grodansparadis/can4vscp_odessa/docs/remotevar.md

No remote variables currently defined for this module.

[filename](./bottom-copyright.md ':include')
