grodansparadis/can4vscp_odessa/docs/_coverpage.md

VSCP logo

# Manual for the Odessa module

Scroll down to view docs.

[Homepage](https://www.vscp.org)
[Docs](https://www.vscp.org/#documentation)
[Downloads](https://www.vscp.org/#download)
[Get Started](./README)
