grodansparadis/can4vscp_odessa/docs/images/odessa1.png

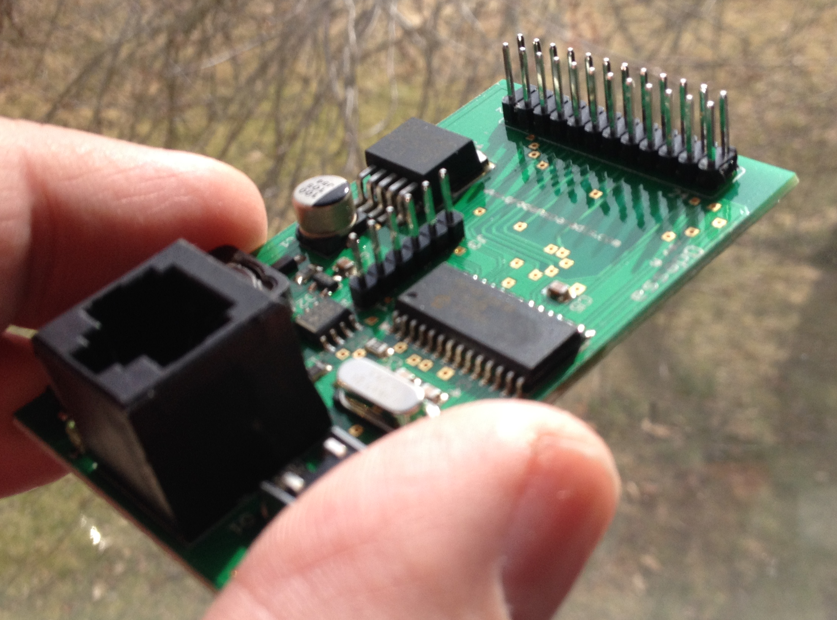
docs/images/odessa1.png
