grodansparadis/can4vscp_odessa/docs/images/odessa2.png

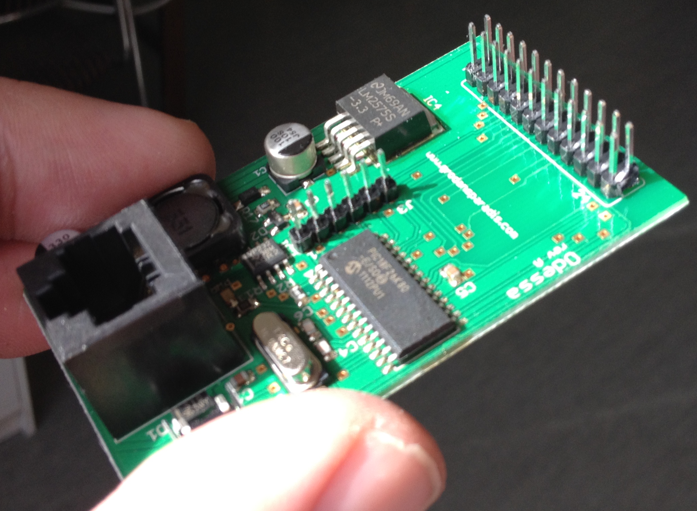
docs/images/odessa2.png
