grodansparadis/can4vscp_odessa/docs/images/odessa3.png

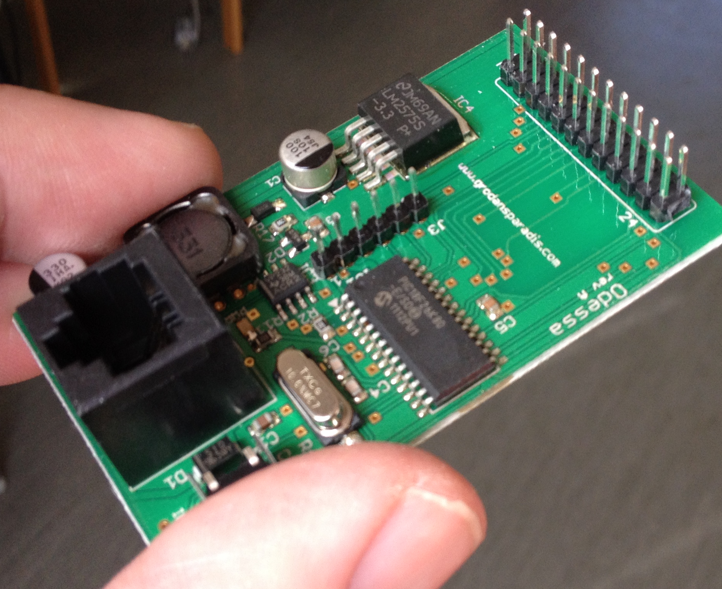
docs/images/odessa3.png
