grodansparadis/can4vscp_odessa/docs/images/odessa4.png

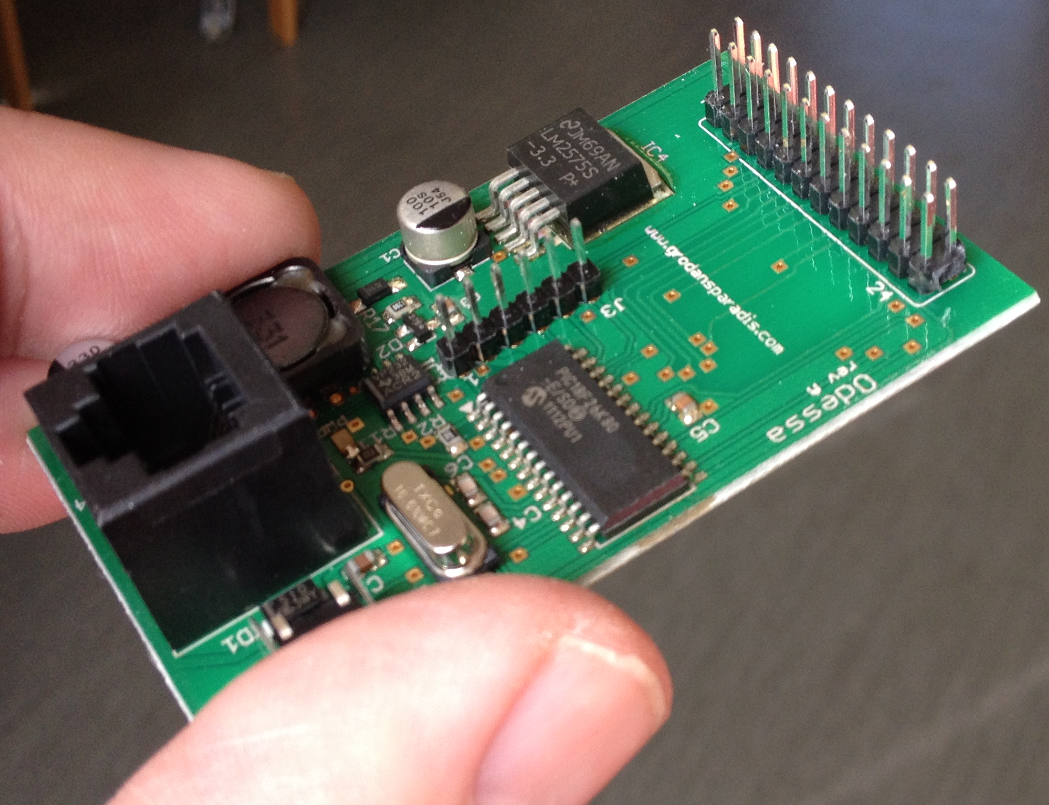
docs/images/odessa4.png
