grodansparadis/can4vscp_odessa/docs/images/odessa5.png

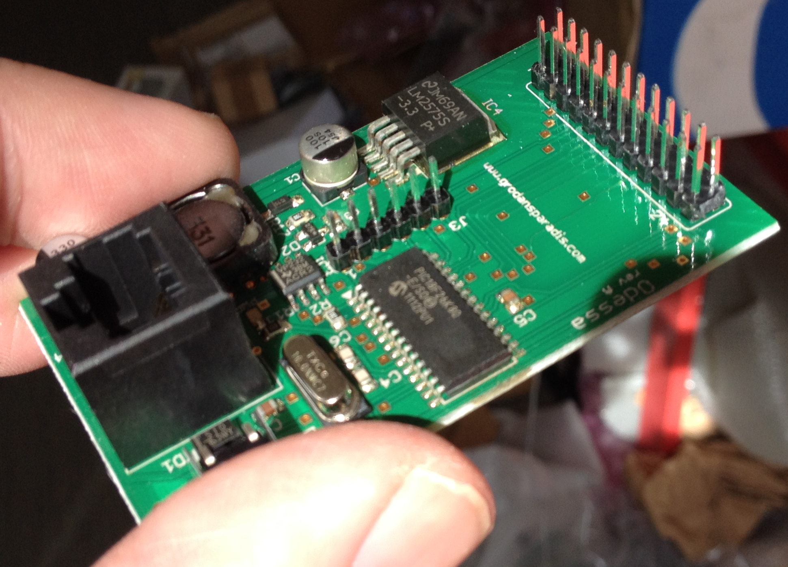
docs/images/odessa5.png
