grodansparadis/can4vscp_odessa/docs/images/odessa7.png

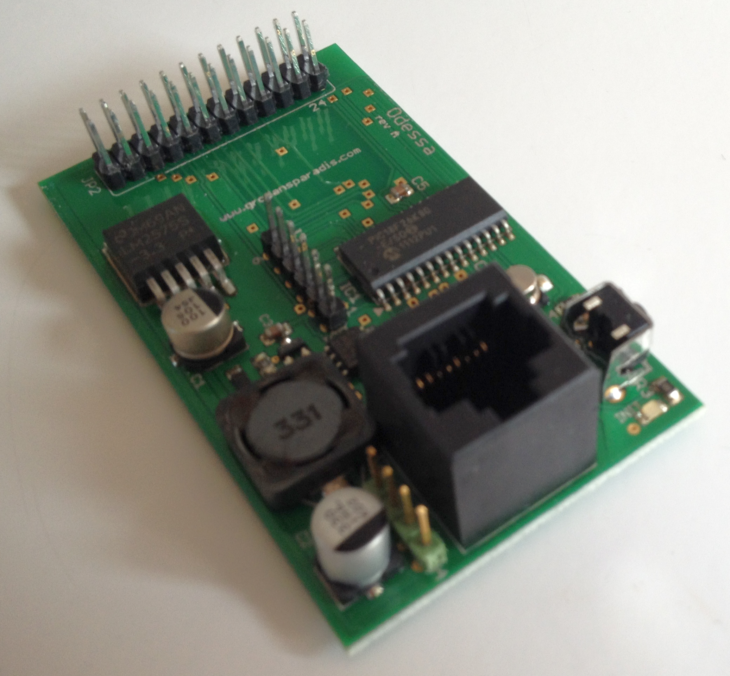
docs/images/odessa7.png
