grodansparadis/can4vscp_odessa/docs/images/odessa8.png

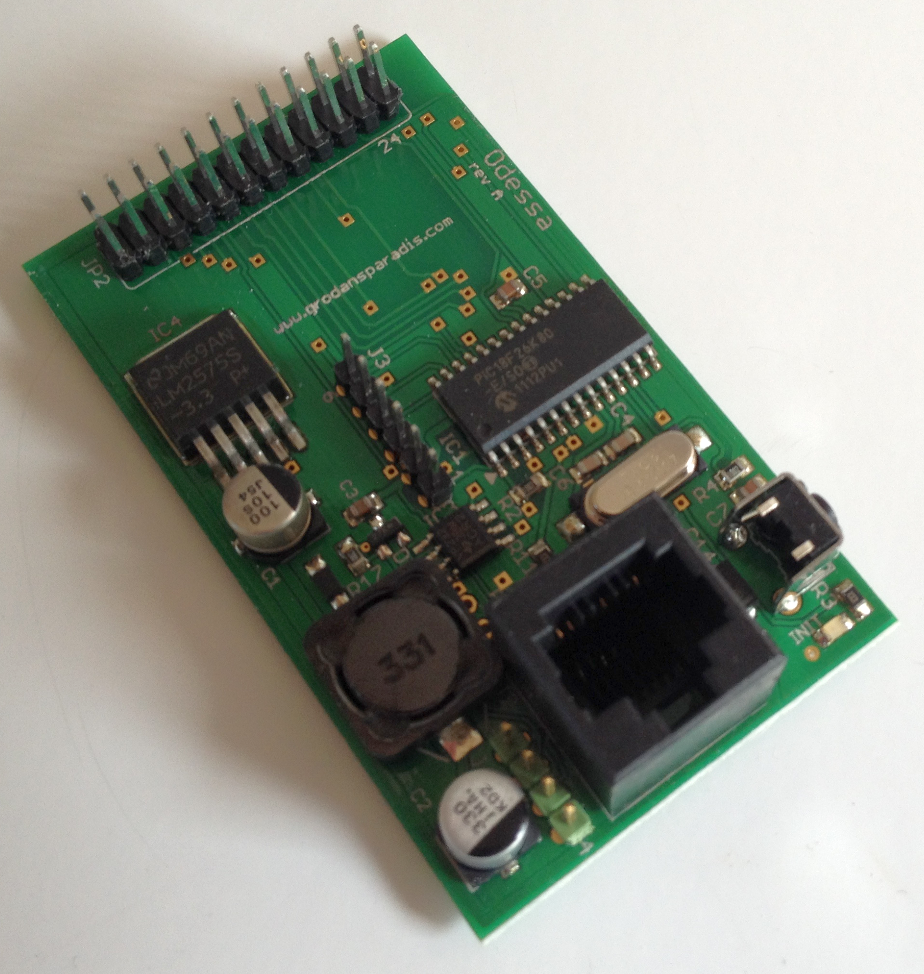
docs/images/odessa8.png
