grodansparadis/can4vscp_odessa/docs/images/odessa9.png

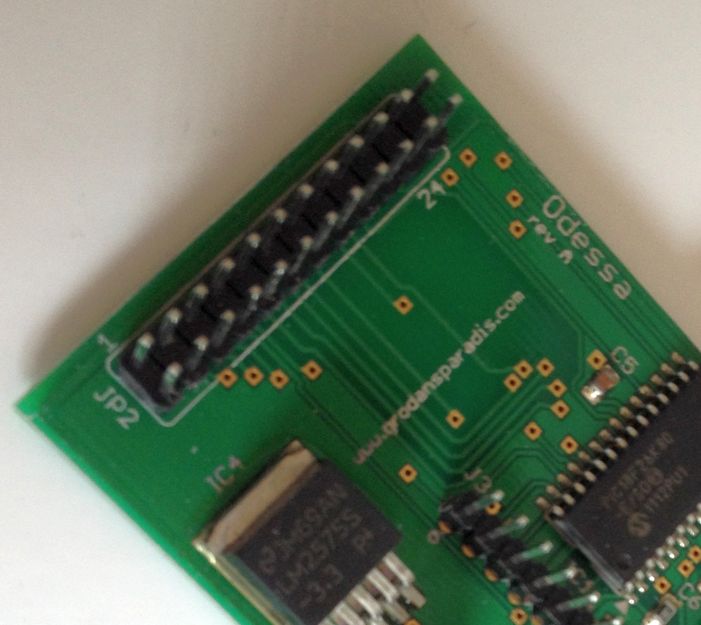
docs/images/odessa9.png
