grodansparadis/can4vscp_odessa/docs/images/odessa10.png

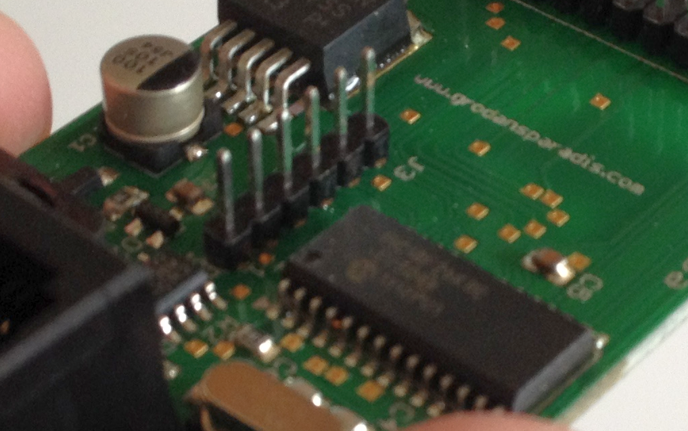
docs/images/odessa10.png
