grodansparadis/can4vscp_odessa/docs/images/odessa11.png

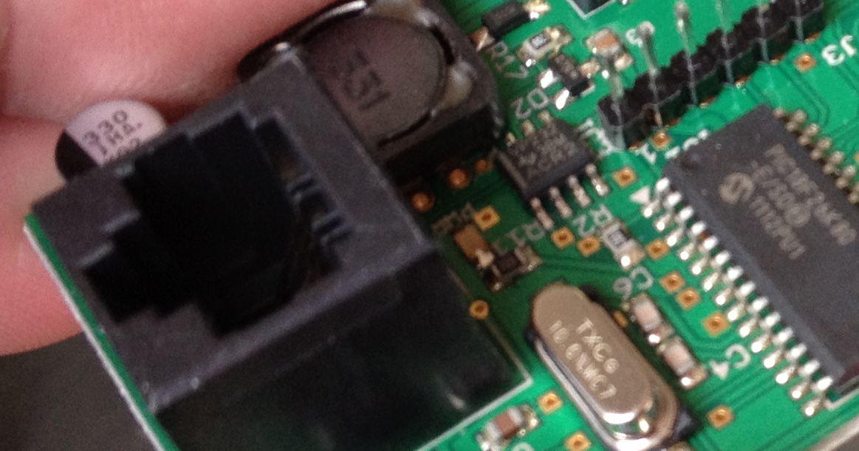
docs/images/odessa11.png
