grodansparadis/can4vscp_odessa/docs/images/odessa12.png

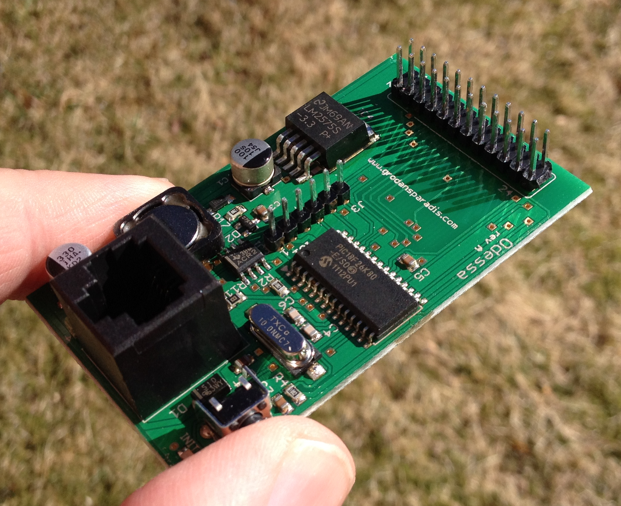
docs/images/odessa12.png
