grodansparadis/can4vscp_odessa/docs/images/odessa13.png

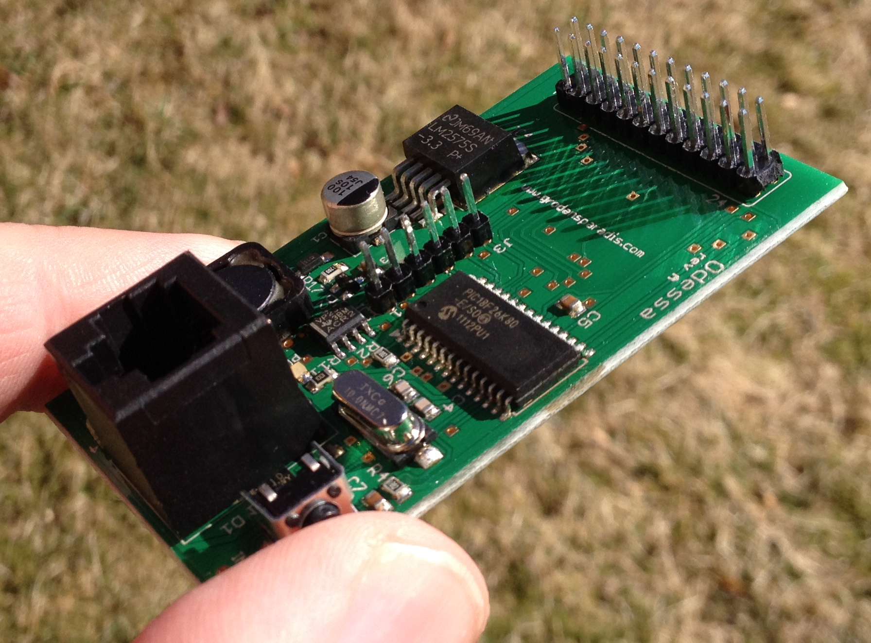
docs/images/odessa13.png
