grodansparadis/can4vscp_odessa/docs/images/odessa15.png

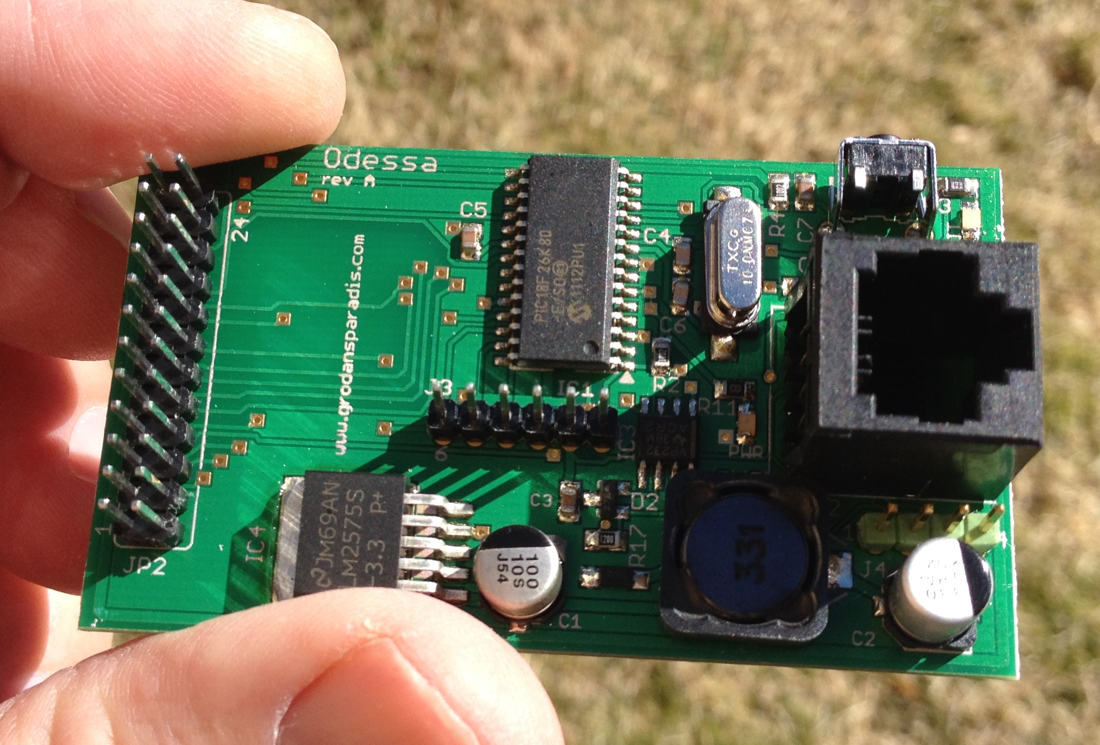
docs/images/odessa15.png
