grodansparadis/can4vscp_odessa/docs/images/odessa16.png

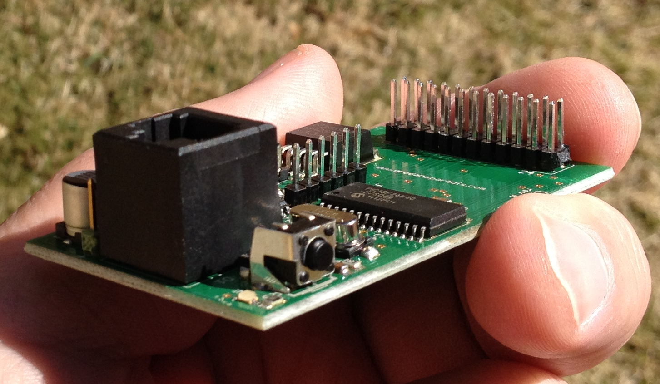
docs/images/odessa16.png
