grodansparadis/can4vscp_odessa/docs/images/odessa_brd_rev_a.png

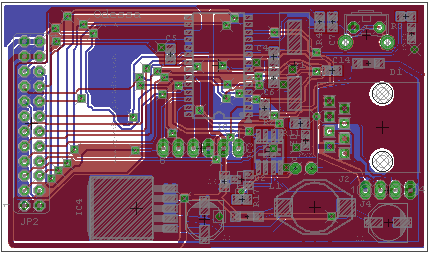
docs/images/odessa_brd_rev_a.png
