grodansparadis/can4vscp_odessa/docs/images/odessa_on_off.png

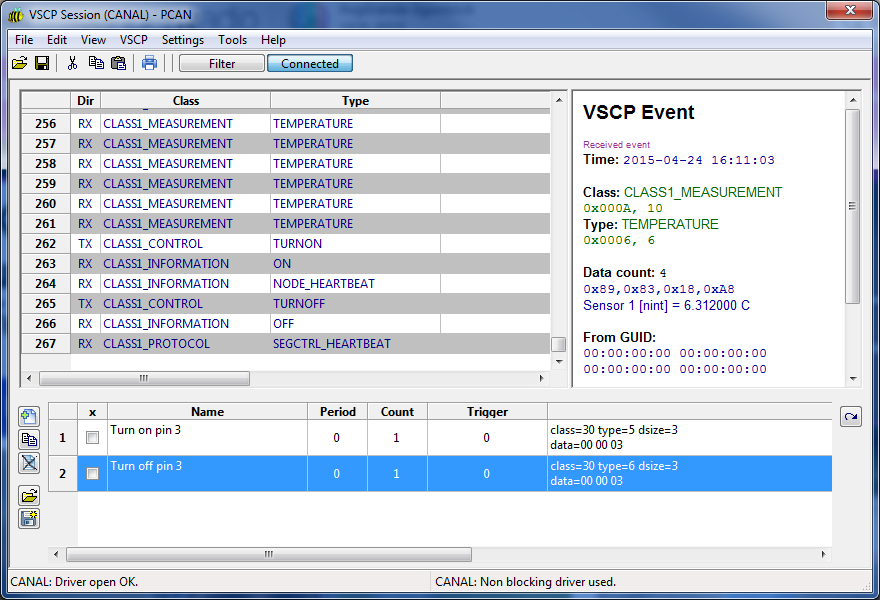
docs/images/odessa_on_off.png
