grodansparadis/can4vscp_odessa/TODO.TXT

Test zone handling in DM
Remove subzone test in action.
