grodansparadis/can4vscp_odessa/docs/faq.md

t.b.d.

[filename](./bottom-copyright.md ':include')
