grodansparadis/can4vscp_odessa/docs/history.md

Change log for the module is at
[here](https://github.com/grodansparadis/can4vscp-odessa/blob/master/HISTORY.txt)
  
[filename](./bottom-copyright.md ':include')
