grodansparadis/can4vscp_odessa/(commit log)

2015-07-27 Fixed problem with send timeout
    [main.c]
2015-08-23 Added schema
    [odessa_rev_A.brd, odessa_rev_A.sch]
2015-11-17 Reported decision matrix info was wrong. Fixed
    [main.c]
2015-12-17 Changed copyright info in headers so it is correct
    [main.c, odessa.h, version.h]
2016-03-23 Fixed bug in control byte write routine
    [odessa_rev_A.brd, odessa_rev_A.sch]
2016-04-19 Brwn out now ar 3V
2020-05-15 init timer is noe 2500 ms
2025-08-18 Converted schema to kicad
    [diff.txt, odessa_rev_A.kicad_pcb, odessa_rev_A.kicad_sch]
2025-09-23 Added folder for design documents
    [diff.txt]
2025-09-30 Cleaned up
    [diff.txt]
